AdityaPathak09/BotCode/PestBot/untitled.brd

## EAGLE design PestBot/untitled.brd (2023-10-12)

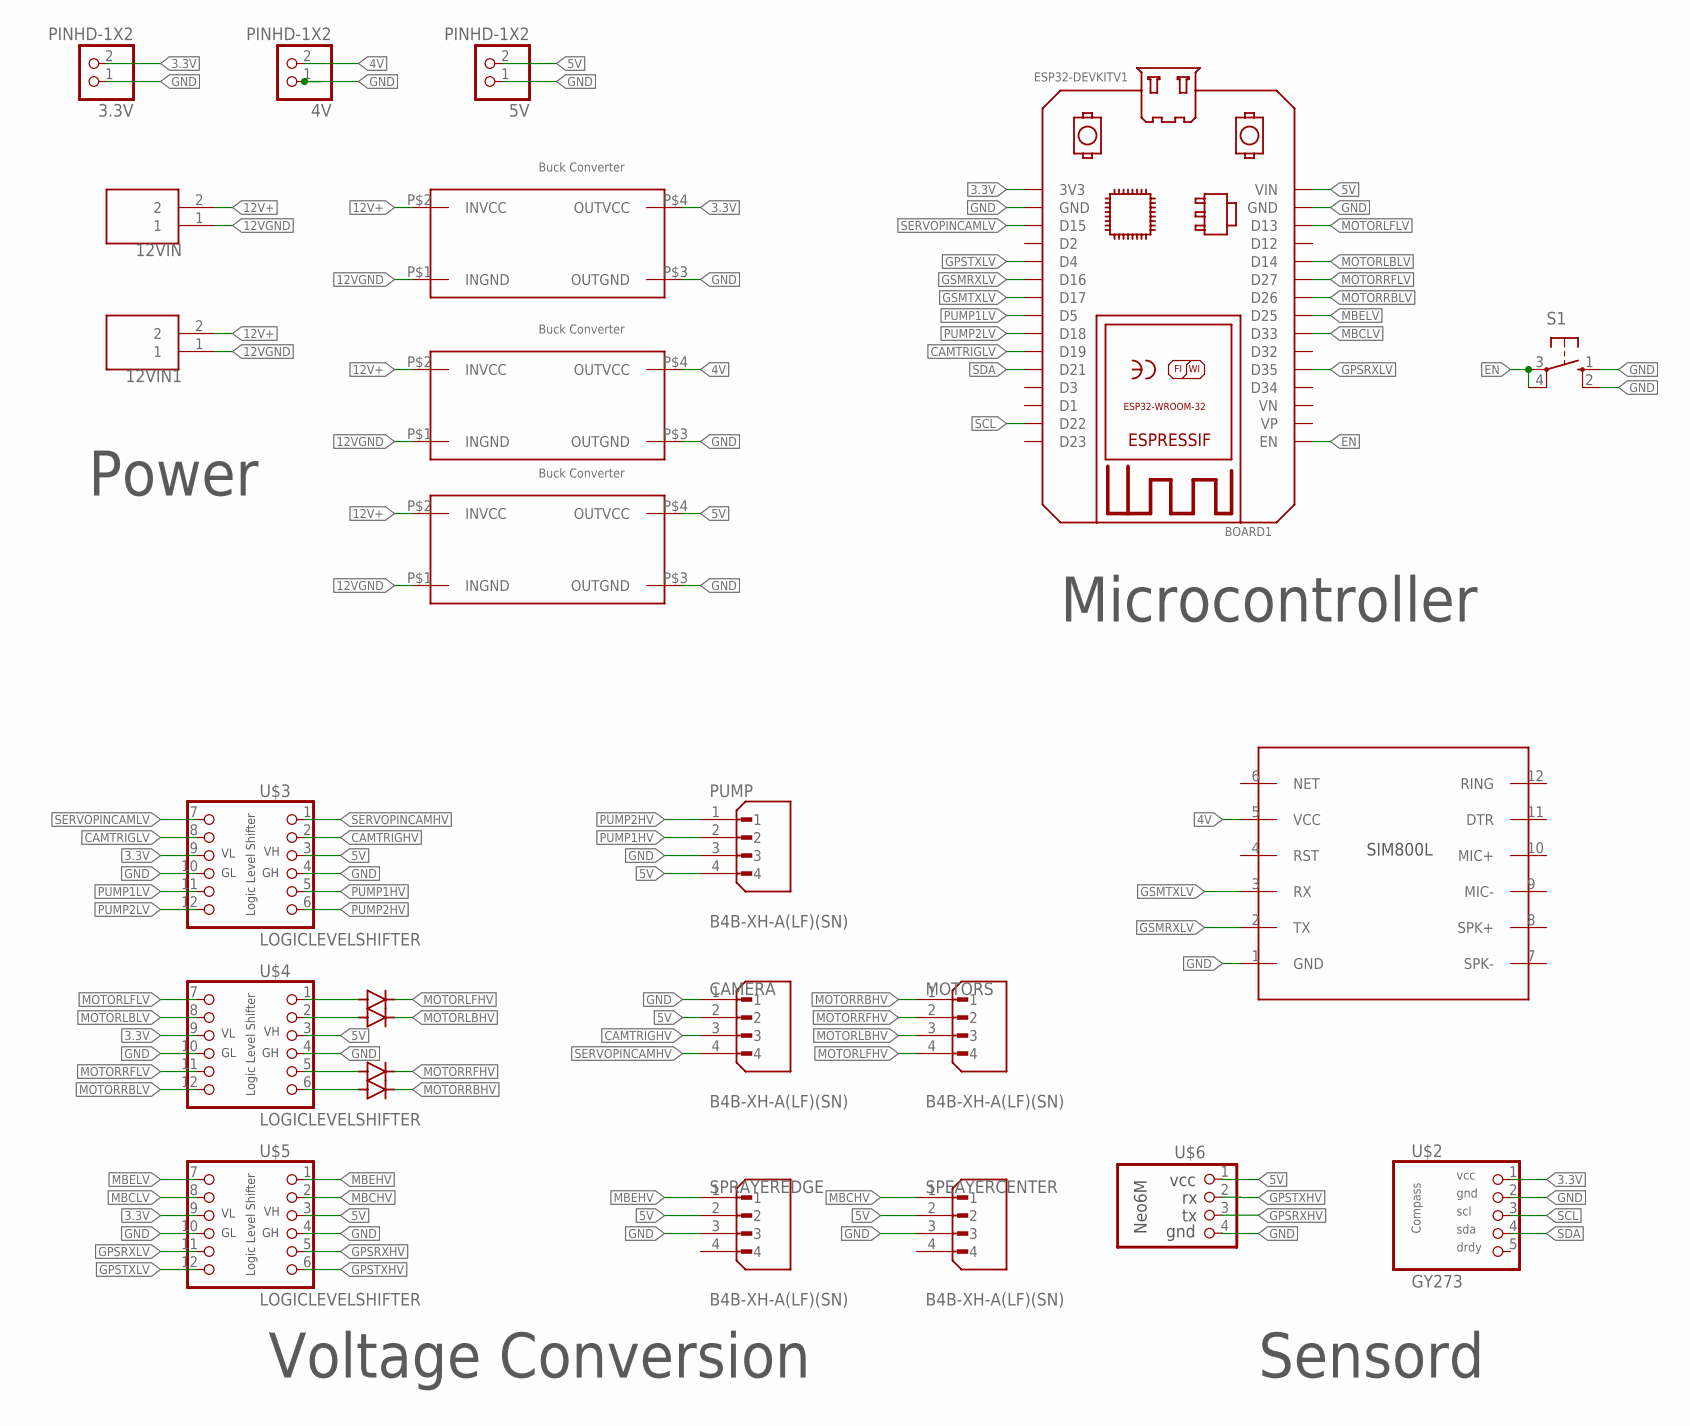
[picture p1: schematic untitled.sch]

Parts:
3.3V, 4V, 5V: PINHD-1X2; 1X02
3.6V: BUCKCONVERTER; 2X2PAD
12VIN, 12VIN1: TB010-508-02BE; CUI_TB010-508-02BE
BOARD1: ESP32DEVKITV1; ESP32-DEVKITV1
CAMERA: B4B-XH-A(LF)(SN); JST_B4B-XH-A(LF)(SN)
D1, D2, D3, D4: 1N5060GP; DO15-12
MOTORS: B4B-XH-A(LF)(SN); JST_B4B-XH-A(LF)(SN)
PUMP: B4B-XH-A(LF)(SN); JST_B4B-XH-A(LF)(SN)
S1: 10-XX; B3F-10XX
SPEAYERCENTER: B4B-XH-A(LF)(SN); JST_B4B-XH-A(LF)(SN)
SPRAYEREDGE: B4B-XH-A(LF)(SN); JST_B4B-XH-A(LF)(SN)
U$1, U$8: BUCKCONVERTER; 2X2PAD
U$2: GY273; 1X05
U$3, U$4, U$5: LOGICLEVELSHIFTER; 1X06
U$6: NEO6M; 1X04
U$7: SIM800L; 6X2DIFF

Connections:
3.3V: 3.3V.2, 3.6V.P$4 (OUTVCC), BOARD1.3V3, U$2.1, U$3.9, U$4.9, U$5.9
4V: 4V.2, U$1.P$4 (OUTVCC), U$7.5 (VCC)
5V: 5V.2, BOARD1.VIN, CAMERA.2, PUMP.4, SPEAYERCENTER.2, SPRAYEREDGE.2, U$3.3, U$4.3, U$5.3, U$6.1, U$8.P$4 (OUTVCC)
12V+: 3.6V.P$2 (INVCC), 12VIN.2, 12VIN1.2, U$1.P$2 (INVCC), U$8.P$2 (INVCC)
12VGND: 3.6V.P$1 (INGND), 12VIN.1, 12VIN1.1, U$1.P$1 (INGND), U$8.P$1 (INGND)
CAMTRIGHV: CAMERA.3, U$3.2
CAMTRIGLV: BOARD1.D19, U$3.8
EN: BOARD1.EN, S1.3, S1.4 (P1)
GND: 3.3V.1, 3.6V.P$3 (OUTGND), 4V.1, 5V.1, BOARD1.GND, BOARD1.GND@1 (GND), CAMERA.1, PUMP.3, S1.1 (S), S1.2 (S1), SPEAYERCENTER.3, SPRAYEREDGE.3, U$1.P$3 (OUTGND), U$2.2, U$3.4, U$3.10, U$4.4, U$4.10, U$5.4, U$5.10, U$6.4, U$7.1 (GND), U$8.P$3 (OUTGND)
GPSRXHV: U$5.5, U$6.3
GPSRXLV: BOARD1.D35, U$5.11
GPSTXHV: U$5.6, U$6.2
GPSTXLV: BOARD1.D4, U$5.12
GSMRXLV: BOARD1.D16, U$7.2 (TX)
GSMTXLV: BOARD1.D17, U$7.3 (RX)
MBCHV: SPEAYERCENTER.1, U$5.2
MBCLV: BOARD1.D33, U$5.8
MBEHV: SPRAYEREDGE.1, U$5.1
MBELV: BOARD1.D25, U$5.7
MOTORLBHV: D2.C, MOTORS.3
MOTORLBLV: BOARD1.D14, U$4.8
MOTORLFHV: D1.C, MOTORS.4
MOTORLFLV: BOARD1.D13, U$4.7
MOTORRBHV: D4.C, MOTORS.1
MOTORRBLV: BOARD1.D26, U$4.12
MOTORRFHV: D3.C, MOTORS.2
MOTORRFLV: BOARD1.D27, U$4.11
unnamed: D1.A, U$4.1
unnamed: D2.A, U$4.2
unnamed: D3.A, U$4.5
unnamed: D4.A, U$4.6
PUMP1HV: PUMP.2, U$3.5
PUMP1LV: BOARD1.D5, U$3.11
PUMP2HV: PUMP.1, U$3.6
PUMP2LV: BOARD1.D18, U$3.12
SCL: BOARD1.D22, U$2.3
SDA: BOARD1.D21, U$2.4
SERVOPINCAMHV: CAMERA.4, U$3.1
SERVOPINCAMLV: BOARD1.D15, U$3.7

Notes on the sheet:
Power
Voltage Conversion
Sensord
Microcontroller

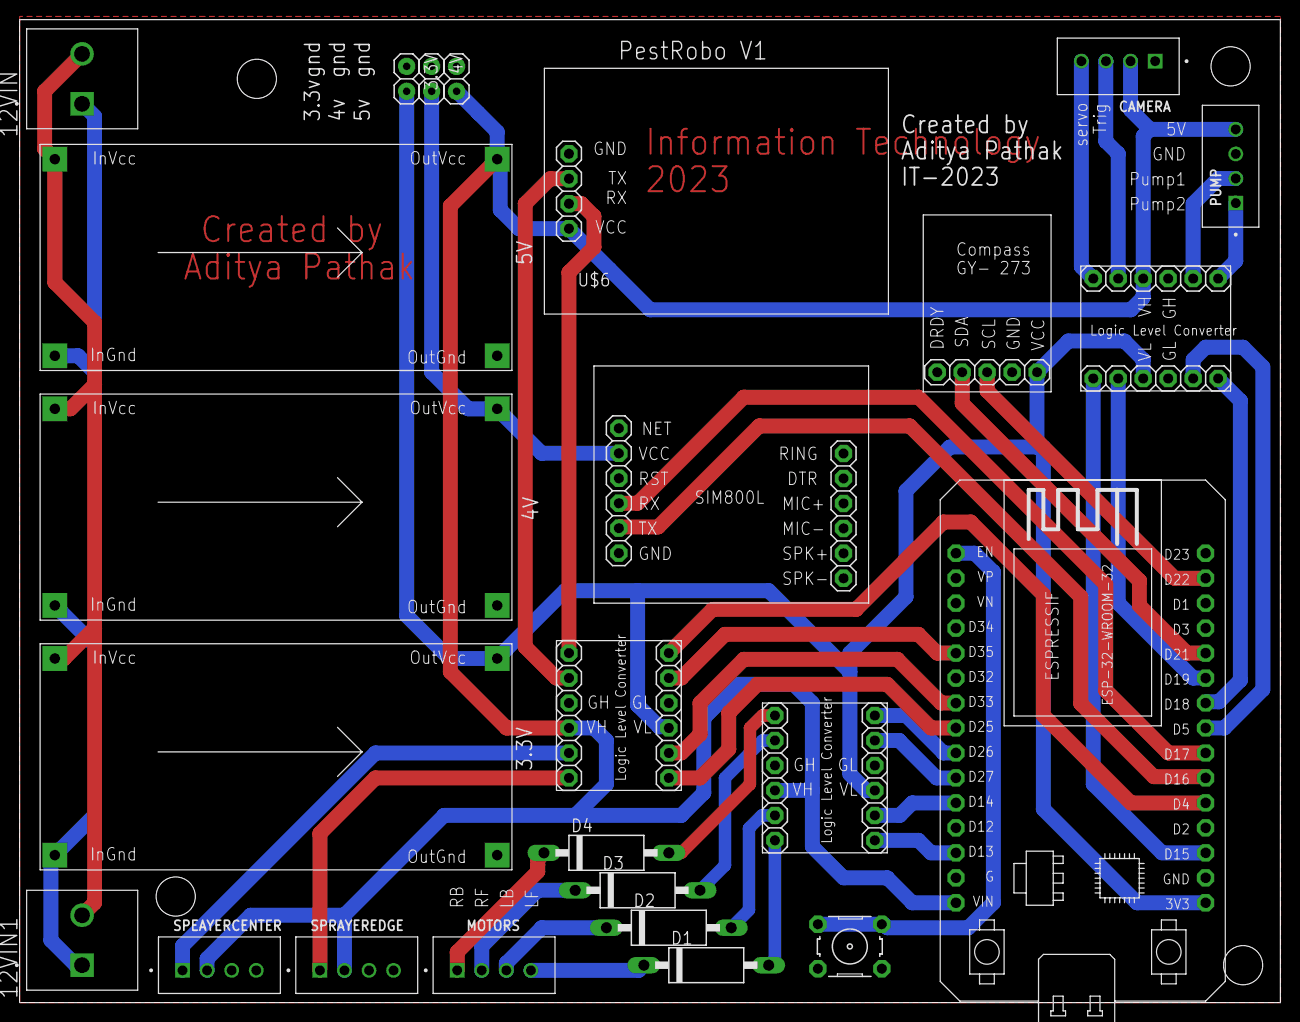
[picture p2: board untitled.brd from above]

Board: 2 copper layers, 128.2 x 100.0 mm, 25 parts (0 on the bottom side), 39 nets.
