AdityaPathak09/BotCode/(commit log)

2023-10-12 1. Added Serial Communication between Bot Controller and Camera to send Flask Serer IP 2. Added recieving flask server IP over Bluetooth 3. Updated GPS pins and compass code
2023-10-12 pcb files added
    [untitled.brd, untitled.sch]
2023-10-14 Worked on GPS Connectivity and FIX
    [BotCode.ino, compass.h, gps.h]
